tjfenwick/DIY-Sim-Racing-Active-Pedal/(list of files, cad)

Other CAD files:
CAD/608 Bearings v1.f3d
CAD/8mm Lead Screw Nut v1.f3d
CAD/8mm T8 Lead Screw (345mm) v1.f3d
CAD/Assembly v15.f3z
CAD/C Clip v1.f3d
CAD/Connector 2 v1.f3d
CAD/Connectors v1.f3d
CAD/Lead Screw Nut Mount v1.f3d
CAD/Load Cell (300 kg) v1.f3d
CAD/Mouting Plate v1.f3d
CAD/NEMA 23 Integrated Easy Servo Motor 130w v2.f3d
CAD/Pedal Connector v1.f3d
CAD/Pedal Mounting Ears v1.f3d
CAD/Pedal Plate v1.f3d
CAD/Pedal v1.f3d
CAD/Pin Long (80mm) v1.f3d
CAD/Pins Shrt (30mm) v1.f3d
