tjfenwick/DIY-Sim-Racing-Active-Pedal/(threads)

Thread 1 (2023-04-14):

ADS1256 Load Cell readings fluctuate and cause the motor to oscillate

tjfenwick, 2023-04-14:
The readings I am receiving from the load cell through the ADS1256 fluctuate around 0.5lbs. This causes the motor to oscillate when trying to hold a constant pressure on the pressure. I have mitigated this by adding a small dead zone on the pedal position that requires a certain number of steps before it will move along with a moving average on my load cell readings to try to smooth it out. The combination of these two has greatly reduced the oscillations but has added a slight lag to the pedal movement.

ChrGri, 2023-04-22:
Thank you so much for this awesome project.

I'm thinking about implementing a Kalman filter to estimate the load from the noisy ADC readings. It might work better than the MA filter, since motion assumptions could be integrated. Perhaps, worth a try.

Alternatively, when two (or N) loadcells are used, their individual reading could be averaged. Which, probably, would reduce noise.

BR

kiss81, 2023-04-23:
Definitely going to build this as well! Thank you for sharing! I was thinking if smoothing the input signal with a small capacitor.  But make sure to read this:
https://electronics.stackexchange.com/questions/218208/smoothing-load-cell-readings-with-a-capacitor

tjfenwick, 2023-04-24:
I am playing to switch over to a 100kg load cell (link below) like you suggested.

I am also plan on trying a ADS1115 or a ADS1015 to see if they work better.
 https://www.ebay.com/itm/385567299710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

ChrGri, 2023-04-25:
These DYLY-107 loadcells look similar to those used on the simucube pedals and the dimensions are reasonably small

https://a.aliexpress.com/_EQln9jz

jgbbob8, 2023-04-25:
I found a tiny one. Yo can check it here https://github.com/jgbbob8/DIY-Sim-Racing-Active-Pedal

kiss81, 2023-04-26:
> I found a tiny one. Yo can check it here https://github.com/jgbbob8/DIY-Sim-Racing-Active-Pedal

I like how small it is. You do need a relative short arm to get a good resolution. Your design seems to cope with that. The downside will be a lot of high force and I am not sure if you're motor will be strong enough to handle it. I do think a longer arm and ~100kg loadcell  will work better to be honest.

tjfenwick, 2023-04-26:
I tried the ads1115 and found the resolution to be not fine enough to smoothly work. Resolution with the 300kg load cell end up only being 0.1kg which lead to the pedal moving in steps rather than a smooth motion. The main problem is the ads1115 doesn't have a large enough gain value. I am going back to the ADS1256 and trying a linear voltage regulator to keep a consistent 5v input.

ChrGri, 2023-04-26:
@tjfenwick in your video, one can see some oscillations when the pedal is ac-/decelerated. Due to this acceleration additional force (F=m*a) will be measured by the loadcell. Do the oscillations you observed also occur, when you decouple the loadcell from the motor, thus the loadcell is not moving at all?

tjfenwick, 2023-04-26:
Yes, the fluctuations occur even when the load cell is completely still. I believe it has to do with the 5v supply from the Arduino flucuating. Just a 0.01mV fluctuation can cause the load cell to read a whole kilogram different. This problem doesn't occur when you have a low sample rate (less than 100 samples per second) since it can average a bunch of measurements. However when you get more and more above 100 sps the fluctuations get worse.

jgbbob8, 2023-04-26:
@tjfenwick  may be a 300kg load cell is to much, I use a 150Kg one and do not press more tahn 75kg.  I thnonk that If I make 75kg presure my range must be about 0 to 50% in a 300 KG cell the range will be 0 to 25% if I am not wrong

ChrGri, 2023-04-26:
@tjfenwick I would have thought, that due to the differential operation of the ADC, reference voltage fluctuations would not have an impact of the loadcell readings. But I'm gonna check the TI documents during the weekend.

tjfenwick, 2023-04-27:
That's what I thought but figured I'd give the linear voltage regulator a try.

The voltage regulator seemed to help as it cut the average fluctuations were cut in half. However I can still see voltage changes on my voltmeter especially when wiggling wires in the breadboard. When wiggling the input voltage wires to the ADS1256 the fluctuations get much worse.

Perhaps using a solderable breadboard would further help with this issue.

jjzurro, 2023-04-28:
Hi,
there are many load cell brake implementations that uses the INA122, it looks very fit for this task..

bbbkada, 2023-04-29:
I use 2 HX711 with Teensy Lc for my loadcells (brakepedal, handbrake), it's easy and doing the job.

ChrGri, 2023-04-30:
> I use 2 HX711 with Teensy Lc for my loadcells (brakepedal, handbrake), it's easy and doing the job.
>
> https://www.sparkfun.com/products/13879

Thanks for the suggestions. I've used the HX711 successfully in passive loadcell pedals. However, the HX711 only supports up to 80SPS. Tried 100SPS with the ADS1256, which resulted in strong oscillations.

ChrGri, 2023-04-30:
@tjfenwick: I've quickly tried an exponential filter, which gives faster response compared to the MA filter. I've made a video of the force readings during some pedal movement. Blue line is the noisy sensor reading, yellow is the MA filter (length=40) and gray is the exp filter (alpha=0.15). The oscillations aren't noticeably worse than with the MA filter, but the lag is reduced significantly.
https://user-images.githubusercontent.com/21274895/235343621-2207ca0e-c85c-4bd4-90c4-0a3b1a32e098.mov

ChrGri, 2023-04-30:
@tjfenwick: Same test, but with a Kalman Filter implementation now.

Blue: instantaneous force measurement
Gray: exp filter output
Yellow: Kalman observation

https://user-images.githubusercontent.com/21274895/235350153-70ea7c90-e059-40ad-acf6-2662aa5a47d3.mov

tjfenwick, 2023-04-30:
Awesome work! I'll have to try both of those filter methods and see how they work for me.

In those video are you using a ADS1256 and what was the sample per second?

ChrGri, 2023-04-30:
> Awesome work! I'll have to try both of those filter methods and see how they work for me.
>
> In those video are you using a ADS1256 and what was the sample per second?

Thank you. Both filters have been uploaded to the fork. ADS1256 was used with 500SPS. Let me know if you need assistance with the tuning. I've tried 1000SPS as well, but the cycle time on the Arduino Nano didn't improve over 500SPS, therefore didn't make sense.

SfcoAwol, 2023-05-10:
hey, I'm an idiot so feel free to ignore this if its not helpful and there might be reason that you haven't done this but when i experienced this problem using potentiometers i was getting spikes that would spike over half the sweep of my pedal and i could never create a large enough deadzone to actually manage it and i found that simply placing a capacitor from the ground to your analog in pin would make all the difference, now I'm sure doing this might introduce a little latency but i would guess that could be minimalized based on the size of cap that you choose

ChrGri, 2023-05-11:
Hi, my pedals are almost ready to go to the sim rig. Only waiting for the custom PCB to be delivered.
The 300kg loadcell works perfect with a shortened cable. I don't notice any pedal oscillation or lag with the proposed Kalman filter.

The closed-loop stepper has been tuned as shown below:
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

Pe0.03: 11 --> 9
Pe0.04: 600 --> 100
Pr0.08: 1600 -> 500

Subjectively speaking, the pedal feel is much smoother and the motor quiter with these changes.

laserbeak, 2023-05-18:
> Subjectively speaking, the pedal feel is much smoother and the motor quiter with these changes.
I've had a look at your fork. Great work. How's testing?

jgbbob8, 2023-05-18:
When will be able the wiring diagram? I do not want to burn anything jajajajaja

ChrGri, 2023-05-18:
@laserbeak @jgbbob8 I've designed and ordered custom PCBs for the DIY pedals. They should come early next week. It was 8€/5PCBs including shipping. If you want, I can release the Gerber files after testing?

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

laserbeak, 2023-05-18:
> @laserbeak @jgbbob8 Thank you. I've designed and ordered custom PCBs for the DIY pedals. They should come early next week. It was 8€/5PCBs including shipping. If you want, I can release the Gerber files after testing?
>

That's very generous of you and yes, I'd be interested. I'm also wondering how your solution mounts to an 80/20 rig. My current fanatec pedals (Clubsport) are directly mounted to mine. I can see myself mounting them with corner brackets, but would still need a footplate to rest my heels.

speedcrafter442, 2023-05-29:
> @laserbeak @jgbbob8 Thank you. I've designed and ordered custom PCBs for the DIY pedals. They should come early next week. It was 8€/5PCBs including shipping. If you want, I can release the Gerber files after testing?
>
> 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

Is there somewere a schematic for this PCB?

ChrGri, 2023-05-30:
https://github.com/ChrGri/DIY-Sim-Racing-Active-Pedal/tree/main/Wiring

Thread 2 (2023-04-23):

Hardware design suggestion

ChrGri, 2023-04-23:
Thanks @tjfenwick for his awesome design. To support this project, let's collect and discuss some hardware realizations to potentially improve the original design.

Loadcell rod:
The original design is 3D printed and I'm not sure how it will last over time.
Since the loadcell already has an M12 thread. Use a short M12 threaded rod on both sides of the load cell. At the end of these threaded rods, use M12 ball joints, e.g.
https://amzn.eu/d/eeJQwHZ
to replace the 3D print and ball bearings.

Body, guides, and lead screw:
The original design is 3d printed.
Of the shelf modules for CNC machines might be applicable here, see e.g.
https://a.aliexpress.com/_Ez9AyIL

Pedal:
Use 2020 extrusions, e.g. like on this pedal set
https://www.najam-simtec.de/i/k2x-pedals

BR
Christopher

ChrGri, 2023-04-24:
I've made a construction from mostly metal norm parts. Parts are already ordered. Going to test it soon.
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

jjzurro, 2023-04-26:
Hi guys,
I really like your project. I don't know how far it can go (car profile simulation, abs simulation, etc), but I love it!!!
I'm a total noob, but maybe it will be a better result using a bldc motor with and esc controller. there is a lot of videos about the fast response, readings precision and torque.

I hope it can help you

kiss81, 2023-04-26:
Love the design! Looks pretty strong! Any chance you can put a list with the components / sizes?

tjfenwick, 2023-04-26:
Right now everything is constantly changing since this is still a very early prototype. Once I get a more finalized design I will put together a bill of materials with links on were to buy everything.

jgbbob8, 2023-04-28:
> Once the electronics and software are done, smaller components will be tested. 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

Very nice, and well resolved the size of the motor under the pedal in the area of   the heels... great idea

jjzurro, 2023-05-02:
Hi everyone!
I love this project and I want to help and build it!!!

-Did you though about including an eeprom for the project for custom profiles? (or maybe a stm32, that is faster  than arduino , also have HID library and have more of everything), I think it's the final goal of having those kind of pedals, to be able to load a specific profile for a specific car....

-I found this, it could be a good cheap option:

[https://www.aliexpress.com/item/32955790850.html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](url)

or this [https://www.aliexpress.com/item/1005004022886871.html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,scm-url:1007.14452.331081.0,pvid:f8129fcf-567c-476d-aa4f-3bb2ed79967b,tpp_buckets:668%232846%238110%231995&pdp_npi=3%40dis%21JPY%215672.0%213913.0%21%21%21%21%21%40210324e516830010253947058eb333%2112000027776359282%21rec%21JP%211775284287](url)

Also, it could be a very good idea to have  a discord channel to discuss all that stuff. Have a nice day!!

AyrtonRicardo, 2023-05-04:
> Once the electronics and software are done, smaller components will be tested. 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

@ChrGri mind sharing the dimensions of the profiles? I do happen to have enough alu profile near me and I want to try out the design.

bbbkada, 2023-05-04:
They have a 3d .step file for download on their wesite, if someone wants inspiration. by the size, of the motor, I guess they have a 130w ?! My uploaded file online Autodesk view, will be up for 30 days if you want a quick peek.
https://autode.sk/3NANJBC

ChrGri, 2023-05-05:
@AyrtonRicardo Sure, I've used 2020 V-Slot profiles, which I had laying around as well. The CAD model has been uploaded to the fork:
https://github.com/ChrGri/DIY-Sim-Racing-Active-Pedal/tree/main/CAD/FromNormParts_V1

However, this is how the current design looks like:
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

These ready-to-go CNC modules are surprisingly cheap.

ChrGri, 2023-05-26:
So I've tested the initial version of my custom PCB design for the ESP32 S2 Mini and it's working beautiful. Here is a picture of it mounted to the pedal:

![Uploading PXL_20230526_101744611.jpg…]()

kiss81, 2023-05-26:
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

That's looking really nice! You already got it working as 'joystick' input device as well? A video would be really nice to see it working. Might copy the whole design and build one myself!

kiss81, 2023-05-26:
That;s serious progress @ChrGri ! Looking forward to the video!

ChrGri, 2023-05-26:
@kiss81 Thank you :) Here is a screenshot showing the joystick output from the pedal and a video showing it in action.

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

https://github.com/tjfenwick/DIY-Sim-Racing-Active-Pedal/assets/21274895/4f2327b7-4ec6-4d88-8ae2-2e65f62bca9d

Ibakha, 2023-05-26:
I don't know if the necessary torque was calculated. I was planning on looking at it this weekend. But if you can place the maximum course in the middle. Is this motor strong enough to hold in place and possibly fight back if the abs were implemented?

kiss81, 2023-05-27:
@ChrGri that looks so useable allready! Anything that needs more improvements? (except things like a pedal plate and configuration panel)
@Ibakha ABS feedback would be really nice. Not sure how that feels / what happens in a real race car if it kicks in?

ChrGri, 2023-05-27:
@kiss81 I drove iRacing yesterday for an hour. Pedal felt awesome, more alive than the passive pedal I have, even though no ABS has been implemented.
Currently the pedal seems to skip some steps and loses its neutral position. So after some driving the pedal tilts more and more towards the ground. I will try to find the reason for this next.

kiss81, 2023-05-27:
So cool to hear! Hopefully the motor is not too weak... Any idea how much pressure you need now to hit the brakes 100%?

Ibakha, 2023-05-27:
@ChrGri Do you have an updated version of your CAD model? I am modelling the pedal with [these](https://www.aliexpress.com/item/1005004876489894.html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), which I think you are using.
I'll have someone looking at my math this week, but I'll try to upload an Excel to calculate the minimum torque needed depending on the geometry of the pedals. Maybe I'm worrying for nothing, but it annoys me.

@kiss81 I don't know if it's different in a race car, but I'm pretty sure the reaction of the pedals is similar to your day to day car. Where the brake pedals is pushing back as the ABS releases the brakes.

kiss81, 2023-05-27:
@ChrGri @Ibakha I just had the opportunity today to drive the simucube active pedals on brake and throttle. The ABS indeed felt really like a road car. You could feel the ABS ON/OFF to keep the tires rotating while the ABS was active. The Throttle felt kind of nice too, but hard to explain what they did actually. Need more time with that.

ChrGri, 2023-05-28:
@Ibakha You can find the CAD model of my previous version here https://github.com/ChrGri/DIY-Sim-Racing-Active-Pedal/tree/main/CAD/FromNormParts_V1. But I don't have an updated CAD model with the CNC module. I've ordered this (SFU1605, 100mm travel), but it should be identical to the ones from other sellers:

https://www.ebay.de/itm/393149454745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

Regarding the force, it's always good to have some kind of analytical model to verify the selected parts. Keep in mind, that you do not really need to apply a lot of torque to block the spindle from turning and therefore stop the pedal movement.

Thread 3 (2023-04-24):

Minimum nema required (totally noob question)

biaggi, 2023-04-24:
Hi I was wondering If I could try to build one with a 3d printer nema 11 or so or it just makes no sense

What do u think?

tjfenwick, 2023-04-24:
Hi, a nema 11 or even 17 stepper motor won't have enough torque or spin
fast enough to give you a realistic pedal feel.

Thanks,
Tristian

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

biaggi, 2023-04-24:
Thank u for your response, I'll check the specifications of the one you are using

Closed 2023-04-24.

Thread 4 (2023-04-26):

some ideas: cheaper motor + electronics

kiss81, 2023-04-26:
I see you have plans to go for a teensie 4.0 for better performance. I do think you want a teensie 4.1 as it can act as USB peripheral (useful for make it an actual controller).

But the whole project is kind of expensive for a DIY if you want to make a three pedal setup for example. Some ideas:

pick a esp32 board as they are cheap and have lot's of performance for < 10$

tmc2209 stepper driver < 10$
https://www.amazon.com/BIGTREETECH-DIRECT-TMC2209-Stepsticks-Motherboard/dp/B07ZQ3C1XW

a nema23 motor
https://www.amazon.de/-/en/23HS9440-26-Stepper-Bipolar-D-shaft-1-8%C2%B0CNC/dp/B084RPGHXH
For the motor I think you can give some advice how many RPM / force is needed. Do you have any idea?

software to use it as 'controller':
https://github.com/lemmingDev/ESP32-BLE-Gamepad
If this doesn't work or gives too much latency I might add a USB joystick controller

I have plans to start experimenting as well, but will start with the motor / electronics / software first.
Would love to hear your thoughts.

GManzato, 2023-04-27:
An open loop stepper motor would make things more complex, you would have to min/max at each start and ensure to have powerful enough to not skip step. I think it's not worth.

tjfenwick, 2023-04-27:
As for the micro controller I decided against the teensy 4.0/4.1 since the stepper motor library needed for high speed movement and acceleration doesn't exist at the moment and I am not skilled enough to write one.

I have switched to an Arduino Pro Micro since it can communicate via USB like a controller. I also decreased the steps per revolution on the motor to 500 to decrease the steps per second required to drive the motor.

ChrGri, 2023-04-27:
@tjfenwick could you post a wiring diagram or photo of your setup for reference?

tjfenwick, 2023-04-27:
Yeah, I'll work on getting one together to post along with updated code.

kiss81, 2023-04-27:
> The other issue with a regular stepper motor is the lack of higher speed torque. Most stepper motors seem to max out around 1600 rmp and lose torque drastically after 1000 rpm. The integrated servo motor I used will spin up to 4000 rpm and hold a decent amount of torque.
>
> You need a high speed motor 2000+rpm other wise your pedal will move to slowly.

I have no experience with integrated servo motors but I do share your concerns on the torque. I don't think we need that much RPM's as the spindles have 2mm pitch. So for like 100mm movement you do need 100rpm to move full in/out in half a second...

ChrGri, 2023-04-28:
@kiss81 I've had a 3D printer with a NEMA17 and TR8 spindle on the z-axis. As far as I remember, the z-axis top speed was approx. 20mm/s before stalling. This was with a TR8 spindle and only a couple of 100 grams to move.

For the application of the active pedals, I roughly guess, that 100mm/100ms are required = 1000mm/s. Where the 100mm comes from the expected travel range of the spindle and the 100ms is the time to completely push the pedal.

From my past experience I am certain, that open loop steppers wouldn't be sufficient. But when it comes to decrease the pricing of this project even further, I would be happy to be proven wrong.

tjfenwick, 2023-04-28:
When calculating how fast your motor needs to be you need to think about how fast you can fully compress your current gas, brake or clutch pedal. I estimated it to be around 0.1-0.2 seconds. To achieve this assuming your max travel distance was 50mm and your ball screw pitch was 5mm/rev you need your motor spinning at 4000rpm. Also remember your motor doesn't start at 4000rpm it will have to accelerate to that speed.

t=(Travel/Pitch)/(RPM/60)

B3N1321, 2024-04-08:
can this design be compatible with this Nema 23 motor?

Just found this amazing item on AliExpress. Check it out! HUF12,788.29  50％ Off | Nema23 Closed Loop Integrated Motor 1.2Nm 2Nm 2.5Nm 3Nm Diameter 8mm Hybrid Integrated Servo Motor with Drive For CNC
https://a.aliexpress.com/_EQKCyEF

Thread 12 (2023-08-28):

Wiring Questions and Problem programming Pro Micro

jman-31, 2023-08-28:
Hey there,

I am working on a design similar to yours and would love to know the wiring you used. Would it be possible to get a photo of your wiring or have you had time to make a diagram? Also, I am pretty good at designing circuits and PCB's so I would be glad to throw my hat in the ring to help with this project. I have attached a photo of my pedal so far. It's going to be belt driven as opposed to direct drive just to make it a smaller package. Still waiting on the belt, gears and a couple of bearings to give it a test, but you are way ahead of me on programming part so I didn't figure to reinvent the wheel.

Also, I tried to upload your code to a Pro Micro and I got the error:
#error "Oops! Your board architecture is not supported yet'" (from the ADS1256 library)
Have you tried this with a Pro Micro? I looked through the ADS1256 library and I didn't see support for the ATmega32u4 processor. I could very well be doing something wrong. Thanks for any advice.

My email is [jer_ulm@yahoo.com](mailto:jer_ulm@yahoo.com) if you want to contact me.

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

ChrGri, 2023-08-29:
Great design :)
The discord server, mentioned in another issue, has a lot of active users and is a good place for discussion.

jman-31, 2023-08-29:
Thanks! I appreciate the info. I visited the discord and it looks like I've got a lot of catching up to do!!

Thread 14 (2024-04-08):

can this design be compatible with this Nema 23 motor?

B3N1321, 2024-04-08:
Just found this amazing item on AliExpress. Check it out! HUF12,788.29  50％ Off | Nema23 Closed Loop Integrated Motor 1.2Nm 2Nm 2.5Nm 3Nm Diameter 8mm Hybrid Integrated Servo Motor with Drive For CNC
https://a.aliexpress.com/_EIIy60P
