tjfenwick/DIY-Sim-Racing-Active-Pedal/(commit log)

2023-04-13 CAD
    Fusion 360 CAD files for Prototype V1
    [608 Bearings v1.f3d, 8mm Lead Screw Nut v1.f3d, 8mm T8 Lead Screw (345mm) v1.f3d, Assembly v15.f3z, C Clip v1.f3d, Connector 2 v1.f3d, Connectors v1.f3d, Lead Screw Nut Mount v1.f3d]
2023-04-13 Fusion 360 CAD Files Prototype V1
    [608 Bearings v1.f3d, 8mm Lead Screw Nut v1.f3d, 8mm T8 Lead Screw (345mm) v1.f3d, Assembly v15.f3z, C Clip v1.f3d, Connector 2 v1.f3d, Connectors v1.f3d, Lead Screw Nut Mount v1.f3d]
2023-04-14 Adding in Arduino Library and Code
    [608 Bearings v1.f3d, 8mm Lead Screw Nut v1.f3d, 8mm T8 Lead Screw (345mm) v1.f3d, Assembly v15.f3z, C Clip v1.f3d, Connector 2 v1.f3d, Connectors v1.f3d, Lead Screw Nut Mount v1.f3d]
2023-04-14 Adding CAD files
    [608 Bearings v1.f3d, 8mm Lead Screw Nut v1.f3d, 8mm T8 Lead Screw (345mm) v1.f3d, Assembly v15.f3z, C Clip v1.f3d, Connector 2 v1.f3d, Connectors v1.f3d, Lead Screw Nut Mount v1.f3d]
2023-04-28 Updated Code to use an Arduino Pro Micro and to communicate with a PC like a controller
    Modified the ADS1256-master library to work with an Arduino Pro Micro
    Added in a joystick accelerator parameter based on pedal position to work as a computer interface device to talk to games/sims.
